Yofuness/subwoofer/poweramp_presets/design_output_ported22.txt

Ported: Vb 82.1 L, fb 22.0 Hz, Ql 7.0; box only (no cabin gain); hump cut to the 100 Hz level, 0 dB above; subsonic 24 dB/oct @ 21 Hz, 3 dB under Xmax at 27 V

Sub Ported22: below 22 Hz the EQ stays 1.7 dB under the Xmax limit (need >= 0)
Sub Ported22: max fit error 1.3 dB, max EQ gain +0.00 dB
  LowShelf      16 Hz  Q  1.40    -5.1 dB
  LowShelf      18 Hz  Q  1.40    -8.3 dB
  Peak          16 Hz  Q  2.70    -4.2 dB
  Peak          18 Hz  Q  5.75    -2.1 dB
  Peak          28 Hz  Q  2.50    -2.0 dB
  Peak          45 Hz  Q  1.94    -2.6 dB
  Peak          61 Hz  Q  2.18    -1.1 dB

Freq | box | box+cabin | Sub Ported22 target/EQ
   12 |  -21.0 |  -21.0 |  -17.7/ -17.5
   15 |  -12.4 |  -12.4 |  -16.4/ -16.0
   18 |   -8.7 |   -8.7 |  -10.0/ -10.4
   20 |   -7.4 |   -7.4 |   -3.6/  -4.6
   25 |   -4.7 |   -4.7 |   +0.0/  -0.1
   30 |   -2.2 |   -2.2 |   +0.0/  -0.1
   35 |   -0.1 |   -0.1 |   +0.0/  -0.2
   40 |   +1.2 |   +1.2 |   -1.2/  -1.1
   45 |   +1.8 |   +1.8 |   -1.8/  -1.9
   50 |   +1.8 |   +1.8 |   -1.8/  -1.9
   55 |   +1.7 |   +1.7 |   -1.7/  -1.7
   60 |   +1.4 |   +1.4 |   -1.4/  -1.5
   65 |   +1.2 |   +1.2 |   -1.2/  -1.3
   70 |   +0.9 |   +0.9 |   -0.9/  -0.9
   80 |   +0.5 |   +0.5 |   -0.5/  -0.5
  100 |   -0.0 |   -0.0 |   -0.0/  -0.1
  125 |   -0.4 |   -0.4 |   +0.0/  -0.0
  160 |   -0.6 |   -0.6 |   +0.0/  -0.0
  250 |   -0.9 |   -0.9 |   +0.0/  +0.0
  500 |   -1.0 |   -1.0 |   +0.0/  +0.0
 1000 |   -1.0 |   -1.0 |   +0.0/  +0.0
 4000 |   -1.0 |   -1.0 |   +0.0/  +0.0
10000 |   -1.1 |   -1.1 |   +0.0/  +0.0
