Yofuness/subwoofer/poweramp_presets/design_output.txt

Gross internal 54.3 L, net 52.7 L (1.86 ft^3)
alpha=1.48  Qtc=1.10  Fc=45.0 Hz

Sub Flatten - Mild (-6): max fit error 3.0 dB, max EQ gain -0.86 dB
  LowShelf      17 Hz  Q  0.71   -15.0 dB
  HighShelf    150 Hz  Q  0.71    -6.0 dB
  Peak          48 Hz  Q  3.60    -2.4 dB
  Peak         154 Hz  Q  1.88    -2.6 dB

Sub Flatten - Strong (-15): max fit error 3.0 dB, max EQ gain -1.18 dB
  LowShelf      17 Hz  Q  0.71   -15.0 dB
  HighShelf    193 Hz  Q  0.71   -15.0 dB
  Peak          47 Hz  Q  4.25    -2.3 dB
  Peak         120 Hz  Q  3.59    -3.7 dB
  Peak         156 Hz  Q  2.85    -6.8 dB
  Peak         210 Hz  Q  1.91    -5.0 dB

Sub Flatten - Max (-30): max fit error 3.6 dB, max EQ gain -1.65 dB
  LowShelf      17 Hz  Q  0.71   -15.0 dB
  HighShelf    192 Hz  Q  0.71   -15.0 dB
  Peak          45 Hz  Q  5.98    -1.6 dB
  Peak         120 Hz  Q  3.89    -7.6 dB
  Peak         151 Hz  Q  3.44   -11.6 dB
  Peak         181 Hz  Q  2.79   -11.2 dB
  Peak         253 Hz  Q  1.91   -10.8 dB
  Peak         498 Hz  Q  0.84    -8.6 dB
  Peak        2132 Hz  Q  0.30   -13.3 dB
  Peak       16000 Hz  Q  0.30   -14.7 dB

Freq | box | box+cabin | Sub Flatten - Mild (-6) target/EQ | Sub Flatten - Strong (-15) target/EQ | Sub Flatten - Max (-30) target/EQ
   15 |  -18.6 |   -1.5 |  -12.0/  -9.0 |  -12.0/  -9.0 |  -12.0/  -9.1
   20 |  -13.2 |   +0.2 |   -6.0/  -5.6 |   -6.0/  -5.6 |   -6.0/  -5.7
   25 |   -8.9 |   +1.8 |   -2.0/  -3.4 |   -2.0/  -3.4 |   -2.0/  -3.5
   30 |   -5.3 |   +3.2 |   -0.5/  -2.1 |   -0.5/  -2.1 |   -0.5/  -2.3
   35 |   -2.5 |   +4.4 |   -1.7/  -1.6 |   -1.7/  -1.6 |   -1.7/  -1.7
   40 |   -0.5 |   +5.1 |   -2.4/  -1.6 |   -2.4/  -1.7 |   -2.4/  -1.8
   45 |   +0.8 |   +5.3 |   -2.7/  -2.5 |   -2.7/  -2.7 |   -2.7/  -2.8
   50 |   +1.5 |   +5.2 |   -2.5/  -2.7 |   -2.5/  -2.5 |   -2.5/  -1.9
   55 |   +1.8 |   +4.8 |   -2.1/  -1.6 |   -2.1/  -1.5 |   -2.1/  -1.7
   60 |   +1.8 |   +4.3 |   -1.6/  -1.1 |   -1.6/  -1.2 |   -1.6/  -1.8
   65 |   +1.8 |   +3.8 |   -1.1/  -0.9 |   -1.1/  -1.2 |   -1.1/  -2.1
   70 |   +1.6 |   +3.4 |   -0.7/  -0.9 |   -0.7/  -1.3 |   -0.7/  -2.5
   80 |   +1.4 |   +2.6 |   -0.0/  -1.0 |   -0.1/  -1.8 |   -0.1/  -3.7
  100 |   +1.0 |   +1.6 |   -1.9/  -1.8 |   -4.8/  -4.2 |   -9.7/  -8.3
  125 |   +0.6 |   +1.0 |   -3.9/  -3.6 |   -9.7/  -9.9 |  -19.3/ -19.4
  160 |   +0.4 |   +0.6 |   -6.0/  -5.9 |  -14.9/ -15.0 |  -29.8/ -29.0
  250 |   +0.2 |   +0.2 |   -6.0/  -5.9 |  -15.0/ -14.9 |  -30.0/ -31.1
  500 |   +0.0 |   +0.0 |   -6.0/  -6.0 |  -15.0/ -15.0 |  -30.0/ -30.7
 1000 |   +0.0 |   +0.0 |   -6.0/  -6.0 |  -15.0/ -15.1 |  -30.0/ -29.2
 4000 |   +0.0 |   +0.0 |   -6.0/  -6.0 |  -15.0/ -15.0 |  -30.0/ -29.9
10000 |   +0.0 |   +0.0 |   -6.0/  -6.0 |  -15.0/ -15.0 |  -30.0/ -30.0
