Yofuness/subwoofer/cad/box_v4_34x15.5in_ortho.png

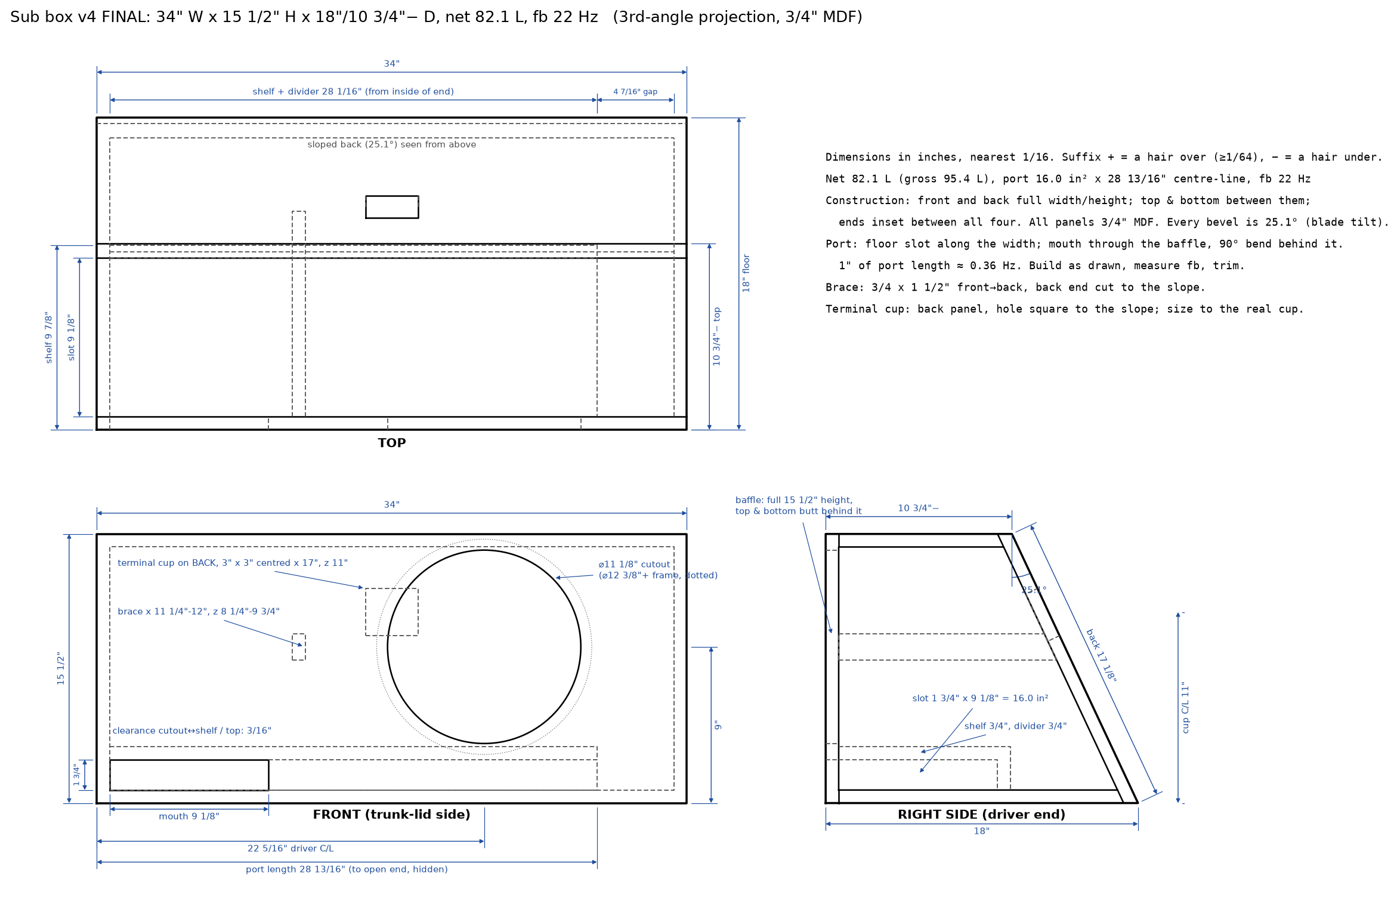
cad/box_v4_34x15.5in_ortho.png
