Yofuness/subwoofer/cad/sheet_nest.png

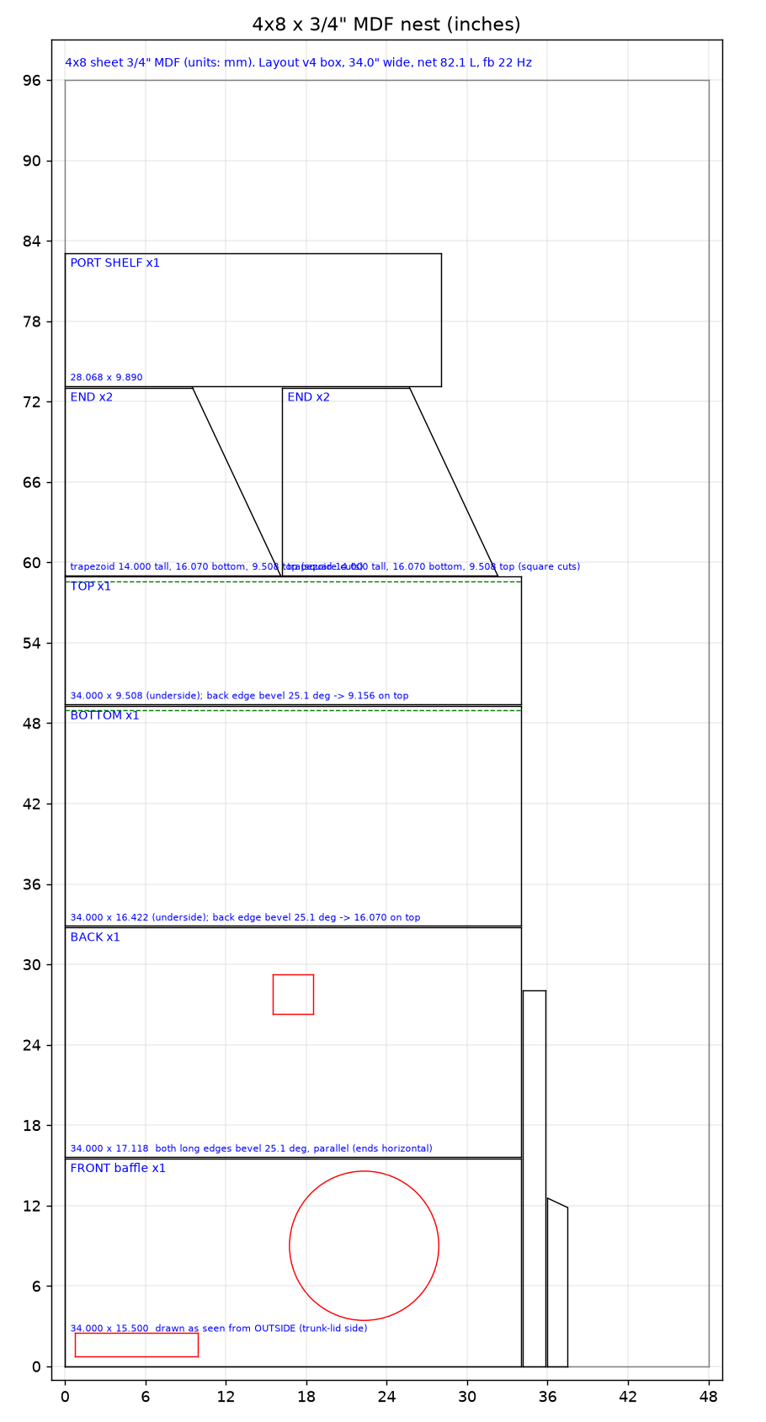
cad/sheet_nest.png
