Yofuness/subwoofer/cad/box_v4_34x15.5in.step

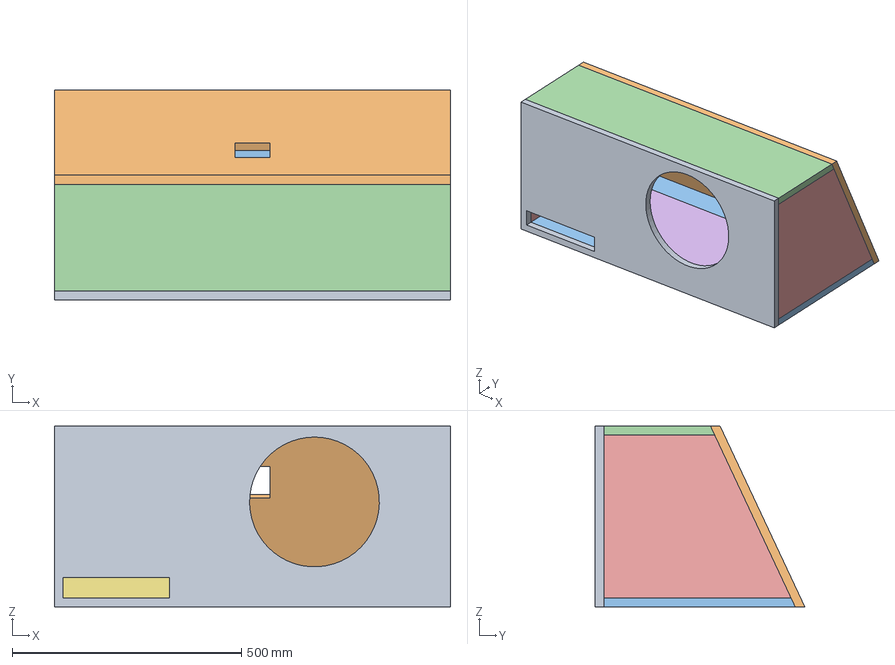
[picture p5: CAD file, 2026-10-17]
cad/box_v4_34x15.5in.step
863.6 x 457.2 x 393.7 mm
