Yofuness/subwoofer/cad/box_v4_38.5in.step

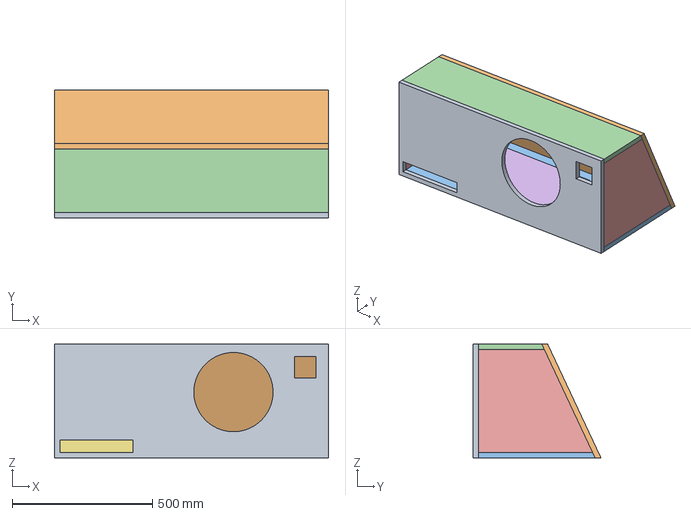
[picture p6: CAD file, 2026-10-15]
cad/box_v4_38.5in.step
977.9 x 457.2 x 406.4 mm
