Yofuness/subwoofer/(list of files, cad)

Other CAD files:
cad/box_v4_34x15.5in.FCStd
cad/box_v4_34x15.5in.dxf
cad/box_v4_38.5in.dxf
subwoofer.skp
