Yofuness/subwoofer/(commit log)

2026-10-13 Subwoofer box project: specs, box designs, models, EQ presets
    Sealed-to-ported redesign for a Pioneer TS-W304R in a Mk4 Jetta trunk:
    - SPECS.md, box-designs.md, PLAN.md, CLAUDE.md project docs
    - max_spl.py and box_compare.html (Xmax/amp-limited SPL model)
    - eq_design.py and Poweramp EQ presets
    - subwoofer.skp (existing box model)
    The Bentley manual is excluded (.gitignore) because it is proprietary.
    [subwoofer.skp]
2026-10-14 PLAN: 3D printing evaluated; MDF box with printed accessory parts
2026-10-14 PLAN: material decision (MDF), moisture and screw notes
2026-10-15 Re-plan for new size limits: side-firing layout v2 (16" H x 27"/24" D, driver's side)
    Compact 45 L: 11.7" W. Big 90.6 L: 20.2" W. Same Vb/fb, so performance unchanged.
2026-10-15 Add 17"-wide medium ported 22 Hz box (75.1 L, 14 in2 port); now Claude's pick
2026-10-15 Add 16"-wide + 1" grate ported 22 Hz box (69.9 L, 13 in2 port)
2026-10-15 Layout v3: 75 L @ 22 Hz, wide and shallow along the seatback (36" W x 16" H x 13.8/10.8" D)
2026-10-15 Measurement list for the max-width box: lid opening, well gap at 3 heights, hinge swing
2026-10-15 Trunk forum data: no opening figure exists, MTX 35-3/4" is the largest proven fit; hinges not gooseneck
2026-10-15 Parametric v4 box CAD: DXF cut sheet, FreeCAD model, STEP at 38.5" (97.6 L, 18 in2 x 27.1" slot)
    [box_v4_38.5in.FCStd, box_v4_38.5in.dxf, box_v4_38.5in.step]
2026-10-16 Final size from cardboard test: 34" W x 15.5" H, 82.1 L; installs through the rear seats
    Lid opening is narrower than 34"; the dummy went through the seat pass-through
    and turned in the trunk, but 16" tall only cleared with cardboard flex.
    box_cad.py now takes a height; 15.5" is the lowest that still fits the driver
    cutout above the port shelf. 38.5" CAD files removed.
    [box_v4_34x15.5in.FCStd, box_v4_34x15.5in.dxf, box_v4_34x15.5in.step, box_v4_38.5in.FCStd]
2026-10-16 Trunk access plan with the box installed: key cylinder (Bentley 55-14) + emergency pull cord
2026-10-17 License: MIT for code, CC BY 4.0 for docs/CAD/presets
2026-10-17 Move terminal cup to the back panel (pass-through access)
    [box_v4_34x15.5in.FCStd, box_v4_34x15.5in.dxf, box_v4_34x15.5in.step]
2026-10-17 Drawings: show panel joints as visible edges (baffle full height, top/bottom behind it)
2026-10-17 Cut plan for a 30in-capacity table saw
2026-10-17 Cut 1 fence setting: sheet width - 34 - kerf
2026-10-17 Poweramp presets for the ported 22 Hz box (cut-only, Xmax-capped subsonic)
2026-10-18 Single ported sub preset: box-only, flat above 100 Hz, Xmax-capped subsonic
